M31-Andromeda/urban-agriculture/data/output_image.jpg

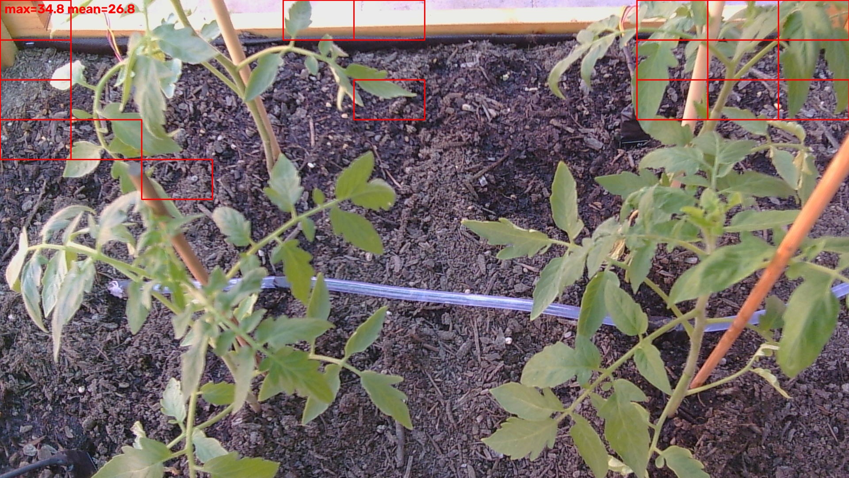
data/output_image.jpg
