M31-Andromeda/urban-agriculture/sketch/sketch.ino

#include <Wire.h>
#include "Arduino_RouterBridge.h"
#include <SPI.h>

// Registers all Bridge handlers and initializes every sensor/actuator.
void setup() {
    Bridge.begin();
    Wire.begin();

    Bridge.provide("get_sht30", read_sht30);

    Bridge.provide("get_moist_v1_2", read_capacitive_moisture_sensor_v1_2);

    Bridge.provide("bme_680_ini", bme680_initialization);
    Bridge.provide("get_bme680", read_bme680);

    Bridge.provide("get_light", read_modulino_light);
    Bridge.provide("light_ini", modulino_light_initialization);

    Bridge.provide("get_ina219", read_ina219);
    Bridge.provide("ina219_ini", ina219_initialization);

    Bridge.provide("set_actuator", set_actuator);

    bme680_initialization();
    modulino_light_initialization();
    ina219_initialization();
    actuator_initialization();
}


// All the work happens over Bridge; nothing needed in the loop.
void loop() {

}
