M31-Andromeda/urban-agriculture/(commit log)

2026-08-06 Primer commit: directorio de Urban Agriculture Group
2026-08-28 sensors.py finished
2026-08-28 sensor bugs solved
2026-08-28 sensor bugs solved2.0
2026-08-29 csv sensor management
    [sensors_data.csv]
2026-08-31 Actualizando para estar al día
2026-08-31 prueba ramaprueba
    [sensors_data.csv]
2026-08-31 TEST BRANCH 2
    [sensors_data.csv]
2026-09-01 quality of life changes
    [sensors_data.csv]
2026-09-01 Quality of life - rework in sensor reading management-
    [sensors_data.csv]
2026-09-02 bugging, extracting quality_of_air VOC
    [sensors_data.csv]
2026-09-02 clean sensors_data
    [sensors_data.csv]
2026-09-02 everything ok
    [sensors_data.csv]
2026-09-02 actuators done, testing remains
    [sensors_data.csv]
2026-09-03 actuators, solar power, QoL
    [sensors_data.csv]
2026-09-07 decision_sys 2.0
    [sensors_data.csv]
2026-09-09 model preview done
    [sensors_data.csv, synthetic_dataset.csv]
2026-09-09 decision_system working
    [historical_sensor_data.csv, sensors_data.csv, synthetic_dataset.csv]
2026-09-09 predictive system done, decision needs to be done
    [sensors_data.csv]
2026-09-09 online_save upload with label 2.0 - bugs solved
    [sensors_data.csv]
2026-09-10 taking pictures for dataset
    [sensors_data.csv]
2026-09-10 documenting + all systems working
    [sensors_data.csv]
2026-09-10 Añadido fichero .py que controla las primeras funciones (independientes al resto de arvhibos) del bot de telegram. Extra la info del google sheets. /estao (devuelve últimos datos)y /estado + hora (de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
2026-09-11 decision and telegram system already up
    [sensors_data.csv]
2026-09-13 Urban Agriculture Alfa 0.1
    [garden_data.csv, sensors_data.csv, synthetic_dataset.csv]
2026-09-13 docstring done, vision_model_5.0
    [garden_data.csv, synthetic_dataset.csv]
2026-09-13 urban agriculture 1.0
    [garden_data.csv]
2026-09-13 readme upgrade6.0
    [garden_data.csv]
2026-09-13 Urban Agriculture v 1.1
    [garden_data.csv]
2026-09-13 Urban Agriculture v 1.2 - vision model 6.0
    [garden_data.csv]
2026-09-14 Urban Agriculture v1.3
    [garden_data.csv]
2026-09-14 Urban Agriculture v1.4
    [garden_data.csv]
2026-09-14 Urban Agriculture v1.5 - README update
    [garden_data.csv]
